Huangye-max/-STC32-/README.md

智能车电磁组的的完整程序
基于STC32G
包含完整的原理图，PCB文件

软件使用：keil uvision 5
PCB建议使用立创EDA，如使用AD可能会导致部分丝印错误
