Huangye-max/-STC32-/(list of files, drawings)

Other design files:
PCB_主板.pcbdoc
PCB_电机驱动板.pcbdoc
PCB_电磁杆.pcbdoc
PCB_运放.pcbdoc
Sheet_电机驱动.schdoc
Sheet_电磁杆.schdoc
Sheet_运放.schdoc
